harrchiu/GEMINI/README.md

# GEMINI - Navigation System

GEMINI is a spacecraft guidance system built from the ground up. The unit is a box-vessel containing gyroscopes, each consisting of papier-mâché encasings and tetrahedral photodiode systems via Arduino Bluetooth. GEMINI wirelessly displays a mission control using Java Swing, updating pitch, yaw, and roll in real-time.

## More Info
Read about the <a href="prospectus.pdf">prospectus</a>, the <a href="final-manual.pdf">operation manual</a>, or various <a href="deviations.pdf">design deviations</a>. <br><br>
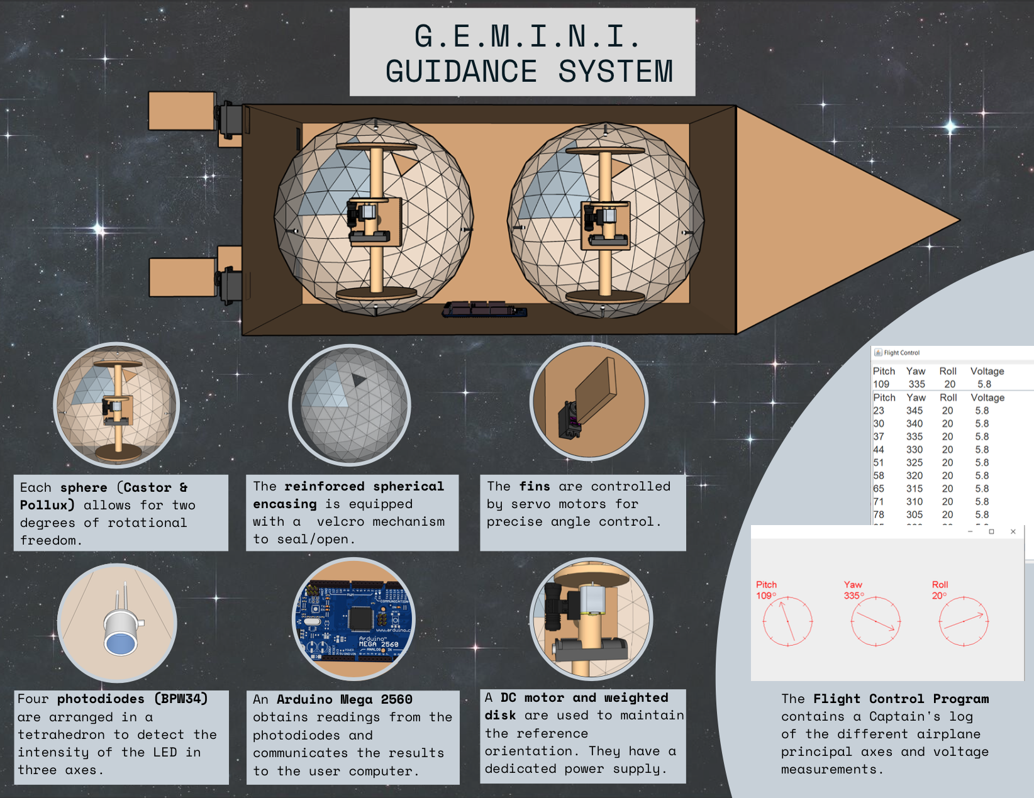
[picture p1: src/infographic.png]
Infographic of Final Product (GEMINI)


## Authors
Jason Cai, <a href="https://www.github.com/harrchiu">Harrison Chiu</a>, <a href="https://www.github.com/alexguo247">Alex Guo</a>, Roger Li & Tom Liu

## License
This project is licensed under the terms of the **MIT** license, which you can read more about [here](https://git.uwaterloo.ca/se101-f20/five-guys/-/blob/master/LICENSE).
