harrchiu/GEMINI/(commit log)

2021-02-18 removed arduino-cpp dir
2021-02-18 removed dup arduino-c nested dir
